jgOhYeah/Farm-PJON-LoRa-network/PumpMonitor/MemoryUsage.ods

Constants
EEPROM Size | 2048
Write endurance | 100000
Bytes per reading | Time between readings (m) | Total Readings Stored | Total stored time (d) | Life expectancy (years)
1 | 15 | 2048 | 21.3333333333333 | 5.70385580652521
2 | 30 | 1024 | 21.3333333333333 | 17.1115674195756
2 | 15 | 1024 | 10.6666666666667 | 8.55578370978782
1 | 30 | 2048 | 42.6666666666667 | 11.4077116130504
2 | 60 | 1024 | 42.6666666666667 | 34.2231348391513
 |  | #DIV/0! | #DIV/0! | 0
 |  | #DIV/0! | #DIV/0! | 0
 |  | #DIV/0! | #DIV/0! | 0
 |  | #DIV/0! | #DIV/0! | 0
 |  | #DIV/0! | #DIV/0! | 0
 |  | #DIV/0! | #DIV/0! | 0
 |  | #DIV/0! | #DIV/0! | 0
 |  | #DIV/0! | #DIV/0! | 0
 |  | #DIV/0! | #DIV/0! | 0
 |  | #DIV/0! | #DIV/0! | 0
 |  | #DIV/0! | #DIV/0! | 0
 |  | #DIV/0! | #DIV/0! | 0
 |  | #DIV/0! | #DIV/0! | 0
