jgOhYeah/Farm-PJON-LoRa-network/ElectricFenceMonitor/Simulations/Results.ods

Sheet: Sheet1
Lower resistor | 4700 | 10000 | 10000 | 10000 | 10000 | 10000 | 18000 | 15000 | 15000 | 15000
Supply voltage | 2.7 | 2.7 | 2.4 | 3.1 | 3 | 3 | 3 | 3 | 3 | 2.4
Lower bias R | 82000 | 82000 | 82000 | 82000 | 82000 | 100000 | 100000 | 100000 | 82000 | 82000
Upper bias R | 120000 | 120000 | 120000 | 120000 | 120000 | 100000 | 100000 | 100000 | 120000 | 120000
Fence | 4.7k lower divider, 2.7V supply | 10k lower divider, 2.7V supply | 10k lower divider, 2.4V supply | 10k lower divider, 3.1V supply | 10k lower divider, 3V supply | 10k lower divider, 3V supply | 18k lower divider, 3V supply | 15k lower divider, 3V supply | 15k lower divider, 3V supply | 15k lower divider, 2.4V supply | 0k lower divider, V supply | 0k lower divider, V supply | 0k lower divider, V supply | 0k lower divider, V supply | 0k lower divider, V supply
0 | 0.428702 | 0.428702 | 0.325486 | 0.57116 | 0.535142 | 0.788621 | 0.788621 | 0.788621 | 0.535142 | 0.325486
2000 | 0.429408 | 0.434631 | 0.330118 | 0.578843 | 0.54239 | 0.798976 | 0.825649 | 0.814729 | 0.554175 | 0.338308
4000 | 0.44867 | 0.58484 | 0.469106 | 0.741609 | 0.702229 | 0.97745 | 1.13881 | 1.08987 | 0.814147 | 0.582139
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
