jgOhYeah/Farm-PJON-LoRa-network/(threads)

Thread 3 (2021-07-01):

This project is beautiful!

gioblu, 2021-07-01:
Ciao @jgOhYeah compliments for the work done, this project is amazing, for sure a lot of people could benefit from it.
I am working on a new project called [BIPLAN](https://github.com/gioblu/BIPLAN) it is an experimental interpreted programming language designed to run on very limited microcontrollers, but include modern features and syntax. It will target both windows, linux and arduino compatible boards, in this moment the arduino support is broken because I am working on it, but you can test it on linux. I suspect it could be useful for you, if you can, let me know what you think about it. It is for now 10 times quicker than TinyBasicPlus and and around 2 times slower than python on linux.

Compliments again for the work done on Farm-PJON_LoRa-network and for publishing in the public domain.

jgOhYeah, 2021-07-02:
Hi @gioblu,
This isn't the best documented or neatest code, but it works :).
BIPLAN sounds interesting.  The main reason I used PICAXE chips with picaxe basic for the remote units was because I didn't have any other mcus with me at the time that would have a low enough power draw and be easily programmable in the field - all that is required to program them is a serial port of some description with a few other components. The picaxe system works well for what it does, but it does show its age at times.

I can see a few situations where I would consider using BIPLAN - for example, being able to have an interactive shell of some description or being able to run code from a non standard location such as an sd card or EEPROM. Would be useful for education as well or coordinating tasks.

I am not sure if I haven't found them yet, but if you are looking for things to add, a few things I would like (might not be possible or fit in with your idea of the language though):
- Command to write directly to registers and read from them. This would allow advanced / unusual features to be accessed if they are not implemented. For example, timers and adc registers.
- Interrupts. Probably architecture specific and anything using them would probably be time critical and need to be done in the c++ code.
- Time elapsed counter (`millis()`).
- Ability to call c++ functions from BIPLAN - so that time critical tasks can be started for example. I haven't ever used it, but apparently mmbasic can do something like this (although again, it is a version of basic).
- Object orientation (ok, probably not possible or fits in within the constraints, but I am starting to like it :) ).

Apart from that, it looks very well documented and structured, so good job. The c++ api looks good as well.

Incidentally, I have been working on a [tune playing](https://github.com/jgOhYeah/TunePlayer) library for Arduinos, which seems to have turned into an interpreter in its own right (although nowhere near as advanced as yours, very specialised and not Turing complete).

gioblu, 2021-07-02:
Thank you for your compliments:
- You have the way of accessing variables and strings as a single global array using:
```ruby
$foo = 1
print $foo # Prints 1
print index $foo # Prints 0 or the index of the first variable defined

print $[0] # Prints 1
$[0] = 0 # Sets $foo to 0
```
- I think Interrupt may not be a good idea because the interpreter is rather slow, probably more viable to call a c function.
- Yes, you have `millis`
- Yes calling a C/C++ function is in the TODO list
- Not sure about OOP

Thank you for the link and compliments for the work done on TunePlayer, I will have soon to implement mono sound, I will for sure check it out.

gioblu, 2021-07-02:
@jgOhYeah forgot to say I plan to support file system not only on linux (which works well already) but also on arduino, using sdcard + sdfat or equivalent.

gioblu, 2021-07-02:
Forgot to say, the target I have in mind for my personal use of BIPLAN is the Smart Response XE, being arduino compatible and having a decent amount of memory and ram.

https://hackaday.com/wp-content/uploads/2021/06/srxebasic_feat.jpg?w=600&h=450

that would be a cool addition to your setup, specially for monitoring and remote-control, although yes, the editor and the compiler could in there, and considering it has a nice qwerty keyboard and screen, you could even write, compile and run program in stand-alone mode.

jgOhYeah, 2021-07-03:
Hi @gioblu,
Good points with the comments on features. In terms of registers, I meant the likes of being able to read and write to the likes of `PORTD`, `TCCR1A` in the Amega328p, allowing finer control over timers and setting pins and directions all at once, although if there is support for calling C/C++ functions, then this is far less important. - In the PICAXE system, where everything has to be in BASIC and the interpreter cannot be updated or reprogrammed once the chip leaves the factory, the ability to write to hardware registers has saved the day a couple of times if something never got implemented or there was a mistake in how it was implemented. This does impact portability though.

My current base station for the farm is a raspberry pi running Thingsboard and a python script acting as a bridge, which while not necessarily the neatest, does most things I need it to.

If you are interested in sound libraries, I haven't tried it, but the [Noodle-Synth](https://github.com/nathanRamaNoodles/Noodle-Synth) library might also be worth a look at as it claims to support multiple notes at a time and directly interprets rttl ringtones without the need to compile tunes like TunePlayer. I only found it after I wrote TunePlayer :)
