jgOhYeah/Farm-PJON-LoRa-network/PumpMonitor/PumpMonitorVeroboardLayout/ExternalConnections.pdf

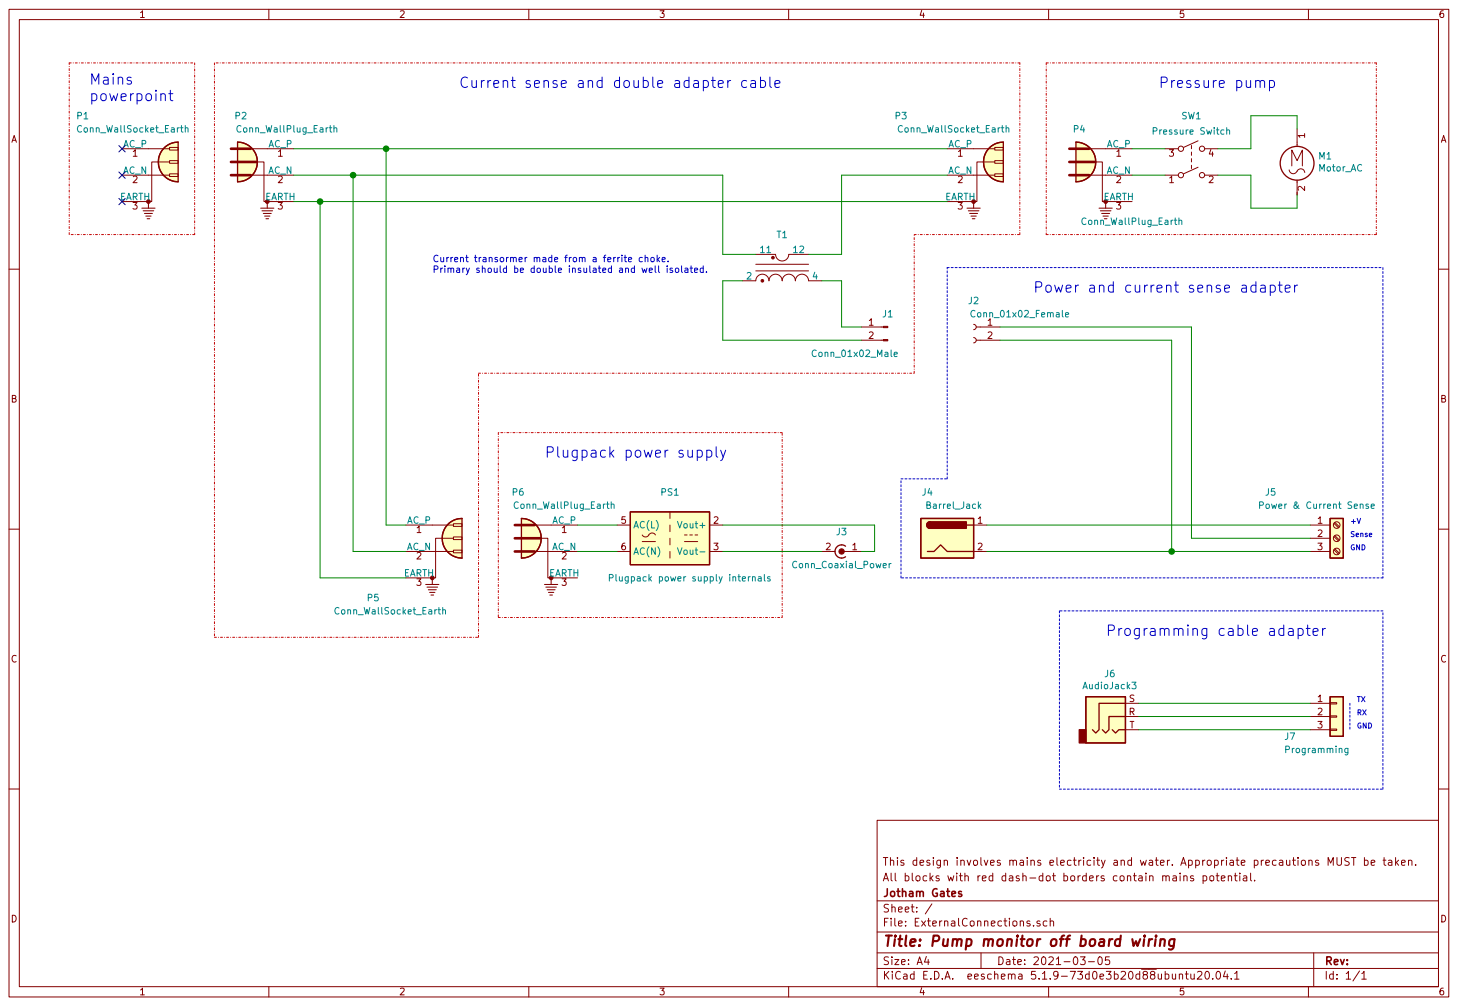
[picture p10: page 1]

TX Current sense and double adapter cable

Sense +V Plugpack power supply

This design involves mains electricity and water. Appropriate precautions MUST be taken.
File: ExternalConnections.sch Sheet: / Jotham Gates All blocks with red dash-dot borders contain mains potential.

Id: 1/1 Title: Pump monitor off board wiring
