jgOhYeah/Farm-PJON-LoRa-network/PumpMonitor/PumpMonitorVeroboardLayout/PumpMonitor.pdf

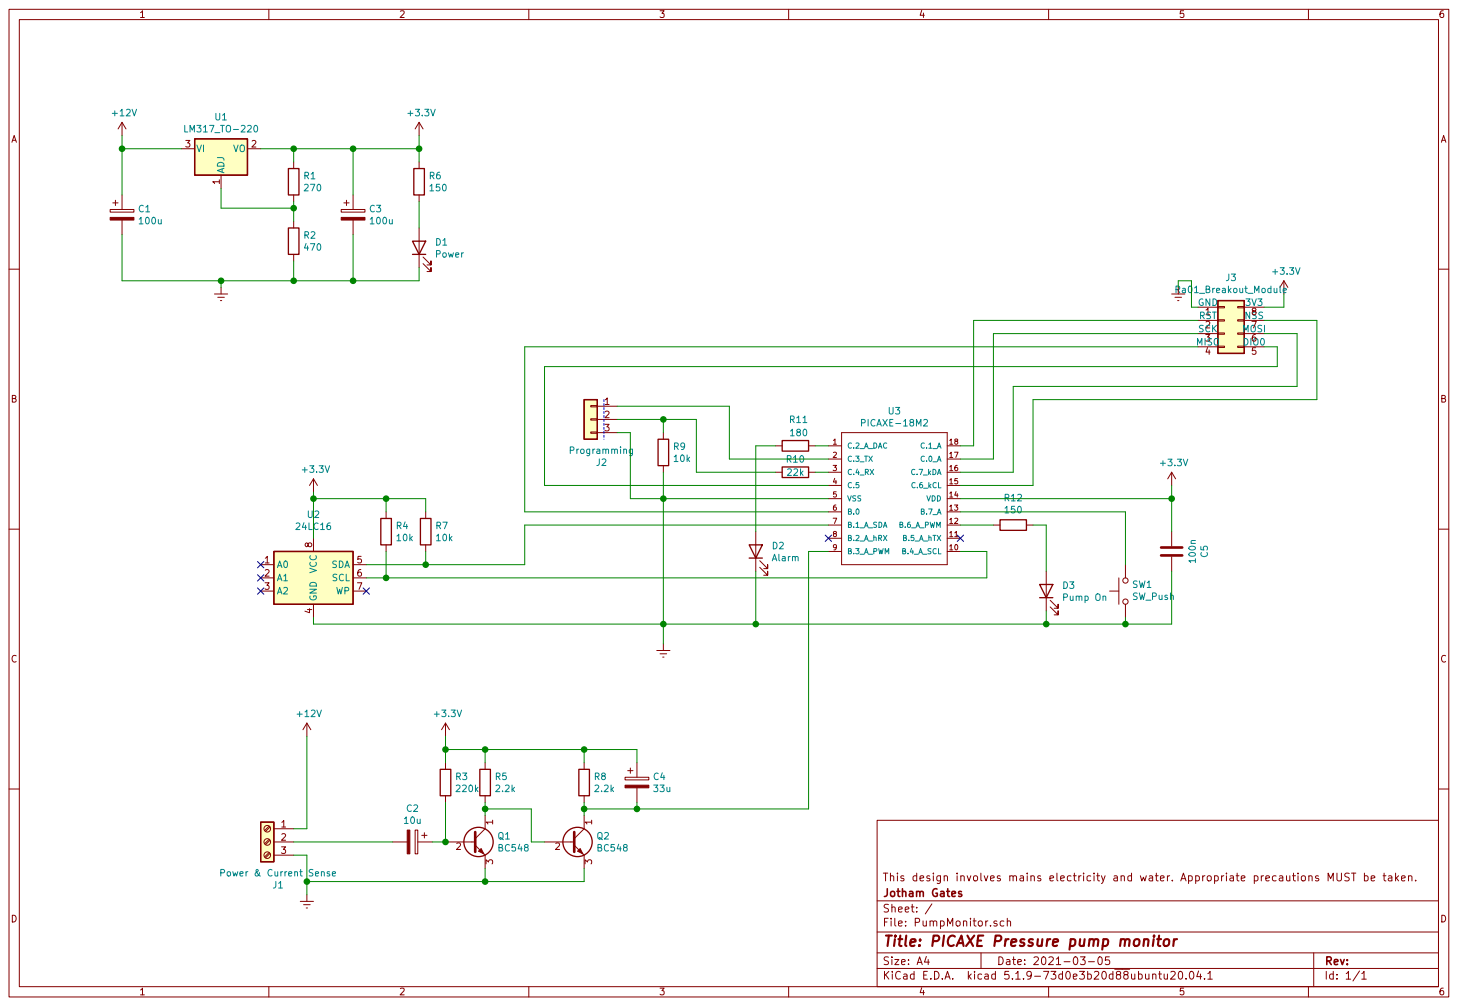
[picture p11: page 1]

4 SDA 5 SCL 6 WP 7 VCC

File: PumpMonitor.sch Sheet: / Jotham Gates This design involves mains electricity and water. Appropriate precautions MUST be taken.

Id: 1/1 Title: PICAXE Pressure pump monitor
