jgOhYeah/Farm-PJON-LoRa-network/ElectricFenceMonitor/ElectricFenceMonitor/drawing.pdf

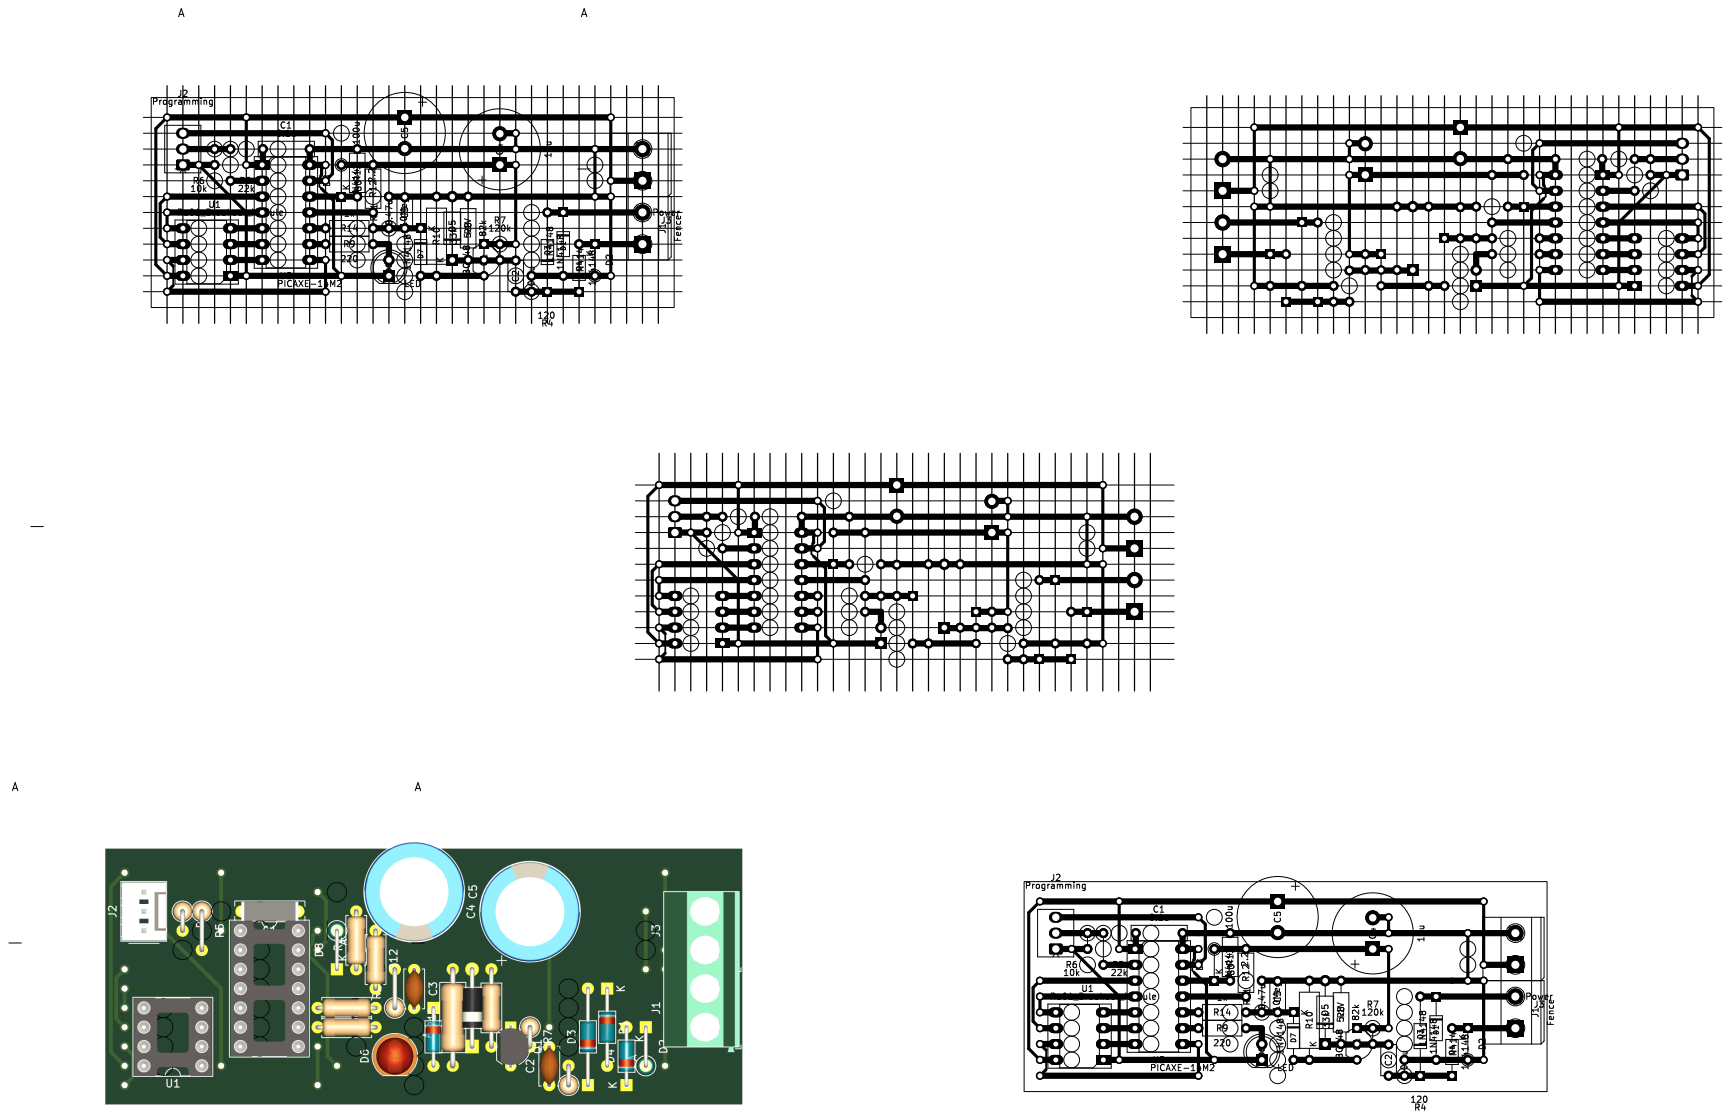
[picture p12: page 1]
