jgOhYeah/Farm-PJON-LoRa-network/ElectricFenceMonitor/Simulations/ElectricFenceMeterSimFullBridge.asc

B1: bv; V=idt(I(V2))
B2: bv; V=temp
B3: bv; V=V(vpeak)/V(varef)*1023
C1: cap; 0.22µ; V=6.3 Irms=2.52 Rser=0.0526265 Lser=0 mfg="KEMET" pn="C0805C224K9RAC" type="X7R"
C2: cap; 0.1µ
C3: cap; 10µ
C4: cap; 3n
D1: diode; 1N4148
D2: zener; UMZ5_1N
D3: diode; 1N4148
D4: diode; 1N4148
D5: diode; 1N4148
D6: diode; 1N4148
D7: diode; 1N4148
Q1: npn; BC547B
R1: res; 24.6Meg
R2: res; 15k
R3: res; 120k
R4: res; 82k
R5: res; 10Meg
R6: res; 33k
R7: res; 180
R8: res; 10k
V1: voltage; PWL value_scale_factor={VSCALE} 0.5 0 repeat forever (file=FencePulse.pwl) endrepeat
V2: voltage; 2.4
Named nets: 0, Vpeak, Vfence, Vdd, SupplyIntegrated, Gfence, Temperature, Varef, ADC
.tran 0 10 0
.step param VSCALE 0 1.5 0.2
.meas tran ave_cur FIND V(supplyintegrated) at 1.0
.meas tran max_output MAX V(Vpeak)
.param VSCALE=0.8
.meas tran max_fence MAX V(Vfence)
.step temp 0 70 20
.op
PULSE(0 2.4 0.1 0.001 0.001 10000)
.meas tran temperature FIND V(temperature) at 1.0
Temperature compensation and ADC
