jgOhYeah/Farm-PJON-LoRa-network/ElectricFenceMonitor/Simulations/ElectricFenceMeterFencePowered.asc

C1: cap; 100µ
D3: diode; 1N4148
D4: diode; 1N4148
D5: diode; 1N4148
D6: diode; 1N4148
R1: res; 1Meg
R2: res; 10Meg
V1: voltage; PWL value_scale_factor={VSCALE} 0.5 0 repeat forever (file=FencePulse.pwl) endrepeat
Named nets: Vfence, Gfence, 0
.tran 0 10 0
.step param VSCALE list 0.1 0.2 0.5 1 1.2
