jgOhYeah/Farm-PJON-LoRa-network/ElectricFenceMonitor/Simulations/ElectricFenceMeterSim.asc

B1: bv; V=idt(I(V2))
C1: cap; 2µ
C2: cap; 0.1µ
D1: diode; 1N4148
D2: zener; UMZ5_1N
Q1: npn; BC547B
R1: res; 20Meg
R2: res; 10k
R3: res; 100k
R4: res; 100k
R5: res; 10Meg
R6: res; 10k
V1: voltage; PWL value_scale_factor={VSCALE} 0.5 0 repeat forever (file=FencePulse.pwl) endrepeat
V2: voltage; 3.3
Named nets: 0, Vpeak, Vfence, Vdd, SupplyIntegrated
.tran 0 10 0
.step param VSCALE list 0.1 0.2 0.5 1 1.2
.meas tran ave_cur FIND V(supplyintegrated) at 1.0
