jgOhYeah/Farm-PJON-LoRa-network/PumpMonitor/CurrentSenseSimulation/20200124_amp_try_2.asc

C1: cap; 33µ
C2: cap; 10µ
D1: diode; 1N914
Q1: npn; BC547B
Q2: npn; BC547C
R1: res; 2.2k
R2: res; 220k
R3: res; 1e6
R4: res; 1k
R5: res; 2.2k
V1: voltage; SINE(0 0.01 50 0.4 0 0 40)
V2: voltage; 3.3; Rser=10
Named nets: 0
.tran 0 2 0 0.01
