jgOhYeah/Farm-PJON-LoRa-network/RasPiBaseStation/pjon.py

#!/usr/bin/python3
# from baseutils import *
# Clone PyLoRa for Python 3 from https://github.com/hnlichong/PyLora/tree/py35

class PJONPacketError(Exception):
    def __init__(self, message, packet = None):
        self.message = message
        self.packet = packet
class CRC:
    def crc32(self, data, length):
        bits = None
        crc = 0xFFFFFFFF
        current = 0
        while length > 0:
            length -= 1
            crc ^= data[current]
            current += 1
            bits = 8
            while bits > 0:
                bits -= 1
                if crc & 1:
                    crc = ((crc  & 0xFFFFFFFF) >> 1) ^0xEDB88320
                else:
                    crc = (crc & 0xFFFFFFFF) >> 1

        return (~crc) & 0xFFFFFFFF

    def crc8_roll(self, input_byte, crc):
        i = 8
        while i:
            result = (crc ^ input_byte) & 0x01
            crc >>= 1
            if result:
                crc ^= 0x97
            
            i-= 1
            input_byte >>= 1

        return crc

    def crc8(self, input_byte, length):
        crc = 0
        for b in range(length):
            crc = self.crc8_roll(input_byte[b], crc)

        return crc

class PJON:
    def __init__(self, id = 255, sender_id = True):
        self.id = id
        self.sender_id = sender_id

    def parse(self, packet): # TODO: FIX CHECKSUM INVALID
        """ Parses a bytearray packet into a tuple containing a list with the
        payload and the sender id. Raises a PJONPacketError if not a valid
        packet or addressed to us. """
        sender_id = None
        header = None
        length = None
        cumulative_length = 4
        is_crc32 = False
        payload = []
        crc = CRC()
        if len(packet) >= 4:
            if packet[0] == 0 or packet[0] == self.id:
                header = packet[1]
                length = packet[2]
                header_checksum = packet[3]
                calculated = crc.crc8(packet, 3)
                if header_checksum == calculated:
                    # Checksums match
                    if header & 0x02 and len(packet) >= 5: # TODO: Fix for if no sender id.
                        # Sender info is included and the packet is long enough
                        sender_id = packet[4]
                        cumulative_length += 1
                        crc_length = 1
                        if header & 0x020:
                            # CRC32 checksum
                            is_crc32 = True
                            crc_length = 4

                        # Get the payload
                        for i in range(cumulative_length, len(packet) - crc_length): # Using len() instead of length to stop truncated packets causing errors
                            payload.append(packet[i])

                        # Check the final crc
                        if is_crc32:
                            calclength = min(length, len(packet))
                            calculated = crc.crc32(packet, calclength - 4)
                            crc = (packet[calclength - 4] << 24) | (packet[calclength - 3] << 16) | (packet[calclength - 2] << 8) | packet[calclength - 1]

                        else:
                            calculated = crc.crc8(packet, length - 1)
                            crc = packet[length - 1]
                        if calculated != crc:
                            raise PJONPacketError("Failed end checksum", packet)
                        return (payload, sender_id)
                    else:
                        raise PJONPacketError("Too short for sender id", packet)
                else:
                    raise PJONPacketError("Failed header checksum", packet)
            else:
                raise PJONPacketError("Not to us", packet)
        else:
            raise PJONPacketError("Too short to be a packet", packet)
    
    def generate(self, to, payload, force_crc32 = False):
        """ Generates a bytes object with the processed packet. """
        # Calculate how long the packet would be if using crc8 or crc32 otherwise
        total_length = len(payload) + 5
        if self.sender_id:
            total_length += 1
        use_crc8 = True
        if force_crc32 or total_length > 15:
            use_crc8 = False
            total_length += 3 # for the 3 bytes crc32 is longer than crc8

        # Build the header
        header = 0 # 0b00100110 # CRC32, ACK, TX info
        if self.sender_id:
            header |= 0b00000010
        if not use_crc8:
            header |= 0b00100000
        
        # Add the header crc8
        crc = CRC()
        packet = [to, header, total_length]
        packet.append(crc.crc8(packet, len(packet)))

        # Add the sender id if requested
        if self.sender_id:
            packet.append(self.id)
        
        # Add the payload
        for i in payload:
            packet.append(i)
        
        # Add the crc at the end
        if use_crc8:
            packet.append(crc.crc8(packet, len(packet)))
        else:
            crc32 = crc.crc32(packet, len(packet))
            packet.append((crc32 >> 24) & 0xFF)
            packet.append((crc32 >> 16) & 0xFF)
            packet.append((crc32 >> 8) & 0xFF)
            packet.append(crc32 & 0xFF)
        
        # Done
        return bytes(packet)


if __name__ == "__main__":
    pjon = PJON()
    data = bytearray(b'\xff&\x10_JV\x80\x00F\x01r\x01\x9a\xfb\xad\x95')
    print(list(data))
    print(pjon.parse(data))
