jgOhYeah/Farm-PJON-LoRa-network/RasPiBaseStation/ExampleData.py

data = [
bytearray(b'\x00\x00\x00\x00\x00'),
bytearray(b'\xff\x16:Wos\x02\x00C\xbd\x01\x02\xd1hS'),
bytearray(b'\xff\xe6_R\x93\\\x9f\x03h\xc0\x01\xb0af\xf8'),
bytearray(b'\xff&\x0f\x07ZP_\x00a\xae\x01\xd9}q\xeb'),
bytearray(b'\xff&\x0f\x07ZP:\x00a\xb2\x01n\xd8\xd4\x8b'),
bytearray(b'\xff&\x0f\x07ZP\x00\x00a\xa2\x01\xcf\x8bf\xfd'),
bytearray(b'\xff&\x0f\x07ZP\x00\x00a\xa3\x01\xd6\x90W\xbc'),
bytearray(b'\xff&\x0f\x07ZP\x00\x00a\xa4\x01\x99\xd1\xc1{'),
bytearray(b'\xff&\x0f\x07ZP\x00\x00a\xa5\x01\x80\xca\xf0:'),
bytearray(b'\xff&\x0f\x07ZP\x00\x00a\xa6\x01\xab\xe7\xa3\xf9'),
bytearray(b'\xff&\x0f\x07ZP\x00\x00a\xa7\x01\xb2\xfc\x92\xb8'),
bytearray(b'\xff&\x0f\x07ZP\x00\x00a\xa8\x015d\x8ew'),
bytearray(b'\xff&\x0f\x07ZP\x00\x00a\xa9\x01'),
bytearray(b'\xff&\x0f\x07ZP\x00\x00a\xaa\x01\x07R\xec\xf5'),
bytearray(b'\xff&\x0f\x07ZP\x00\x00a\xab\x01\x1eI\xdd\xb4'),
bytearray(b'\xff&\x0f\x07ZP\x00\x00a\xac\x01Q\x08Ks'),
bytearray(b'\xff&\x0f\x07ZP\x00\x00a\xad\x01H\x13z2'),
bytearray(b'\xff&\x0f\x07ZP\x00\x00a\xaf\x01z%\x18\xb0'),
bytearray(b'\xff&\x0f\x07ZP\x00\x00a\xb5\x01\xca\x08\xe2k'),
bytearray(b'\xff&\x0f\x07ZP\x00\x00a\xb6\x01\xe1%\xb1\xa8'),
bytearray(b'\xff&\x0f\x07ZP\x00\x00a\xbc\x01\x1b\xcaY"'),
bytearray(b'\xff&\x0f\x07ZP\x00\x00a\xbf\x010\xe7\n\xe1'),
bytearray(b'\xff&\x0f\x07ZP\x00\x00a\xc5\x01\xe57\x9b\x9d'),
bytearray(b'\xff&\x0f\x07ZP\x0e\x01a\xb1\x01\xa9\xe8\xfek'),
bytearray(b'\xff&\x0f\x07ZP\x10\x15a\xbe\x01)\xfc;\xa0'),
bytearray(b'\xff&\x0f\x07ZP\x8a\x01a\xae\x01 \xd4\xe6\xa7'),
bytearray(b'\xff&\x0f\x07ZP\x9e\x04a\xa3\x017\xc4Y\x9a'),
bytearray(b'\xff&\x0f\x07ZP\xaf\x00a\xb4\x01!d\xdbm'),
bytearray(b'\xff&\x0f\x07Zp\xbb \xeb\x90\x05_N\x88\xb9'),
bytearray(b'\xff&\x0f\x07ZP\xf5\ra\xa7\x01\xc0B\x95H'),
bytearray(b'\xff&\x0f\x07ZP\xfd\x00a\xa5\x010nd\xd6'),
bytearray(b'\xff&\x0f\x07ZP2\x00a\xa8\x01\xee\x85e\x91'),
bytearray(b'\xff&\x0f\x07ZP4\x00a\xa3\x01\x821I\xfa'),
bytearray(b'\xff&\x0f\x07ZP4\x00a\xa8\x01a\xc5\x901'),
bytearray(b'\xff&\x0f\x07ZP5\x00a\xaa\x01n\x93\xdb\x03'),
bytearray(b'\xff&\x0f\x07ZP5\x00a\xb8\x01\x16g\xab\xd0'),
bytearray(b'\xff&\x0f\x07ZP6\x00a\xb9\x01H\xdc\xe0A'),
bytearray(b'\xff&\x0f\x07ZP7\x00a\xaf\x01i$|&'),
bytearray(b'\xff&\x0f\x07ZP7\x00a\xb3\x01\x8fS!{'),
bytearray(b'\xff&\x0f\x07ZP7\x00a\xb5\x01\xd9\t\x86\xfd'),
bytearray(b'\xff&\x0f\x07ZP8\x00a\xae\x01\xf2o\xda\xb6'),
bytearray(b'\xff&\x0f\x07ZP8\x00a\xb4\x01BB m'),
bytearray(b'\xff&\x0f\x07ZPc\x08a\xa9\x017Y\x9aD'),
bytearray(b'\xff&\x0f\x07ZPm\x00a\xa5\x01\xe1hC\xc6'),
bytearray(b'\xff&\x0f\x07ZPW\x01a\xb5\x01\xf8\x87\x96\xd5'),
bytearray(b'\xff&\x10_JV}\x00F\x01r\x013\xf7\xa7R'),
bytearray(b'\xff&\x10_JV\x7f\x00F\x01r\x01~?\x06Y'),
bytearray(b'\xff&\x10_JV\x80\x00F\x01r\x01\x9a\xfb\xad\x95'),
bytearray(b'\xff&\x10_JV\x81\x00F\x01r\x01Q\xa7~0'),
bytearray(b'\xff&\x10_JV\x82\x00F\x01r\x01\xd73\x0c\x9e'),
bytearray(b'\xff&\x10_JV\x83\x00F\x01r\x01\x1co\xdf;'),
bytearray(b'\xff&\x10_JV\x84\x00F\x01B\x01\x01j\xef\x83'),
bytearray(b'\xff&\x10_JV\x84\x00F\x01r\x01\x01j\xef\x83'),
bytearray(b'\xff&\x10_JV\x85\x00F\x01r\x01\xca6<&'),
bytearray(b'\xff&\x10_JV\x86\x00F\x00r\x01M`$\xbf'),
bytearray(b'\xff&\x10_JV\x86\x00F\x01r\x01L\xa2N\x88'),
bytearray(b'\xff&\x10_JV+\x00F\x01r\x01\xb5c\xd5\xfc'),
bytearray(b'\xff&\x10_JV~\x00F\x01r\x01\xb5c\xd5\xfc'),
bytearray(b'\xff&\x10_JVx\x00F\x01r\x01c:6\xe1'),
bytearray(b'\xff&\x10_JVy\x06F7r\x01~?\x06Y'),
bytearray(b'\xff&\x10UJV~\x00F\x01r\x01\xb5c\xd5\xfc'),
bytearray(b'\xff&\xd5UJV}\x00N\x01ra3\xf7\xa7R'),
bytearray(b'\xff>?\x9aC\x19G\x04-\xbf\x02\xf7\xfb\xff\xe5'),
bytearray(b'\xffF\x0f\x0bZd:\x8ak\x1a\x085\x88W\xb3'),
bytearray(b'J\x06\x07\xff\xff\xf3~'),
bytearray(b'J\x06\x08\x90\xff\xc6\x00\xc6'),
bytearray(b'J\x06\x08\x90\xff\xc6\x01@'),
bytearray(b"\xff&\x0f\x07ZP\x00\x00a\xb1\x01\xaed\'o")
]
