jgOhYeah/Farm-PJON-LoRa-network/(commit log)

2021-01-27 Add battery volts monitor, base station and readme
    [BatteryMonitorVeroboardLayout.kicad_pcb, BatteryMonitorVeroboardLayout.sch]
2021-03-01 Added PumpMonitor Files
    [20210114_1510.ods, MemoryUsage.ods]
2021-03-13 Added pump monitor
    [ExternalConnections.sch, PumpMonitor.kicad_pcb, PumpMonitor.sch]
2021-03-21 Started splitting into slots, slot 0 should work.
2021-03-21 Theoretically works, updated schematic
2021-04-04 Got interrupts working
2021-04-05 Tidied and version running on pump currently
    [MemoryUsage.ods, RecordedData.ods]
2021-04-05 Copied Raspi Files across
    [records.csv]
2021-06-29 Added interval support to Arduino
2021-07-02 Got RPC Working and updated
    [records.csv]
2021-12-02 Added prototype water baby
2021-12-03 As running on pump
2023-02-21 Cleaning up and adding resetting + temperature consisency detection
    [ExternalConnections.kicad_sch, ExternalConnections.sch, PumpMonitor.kicad_pcb, PumpMonitor.kicad_sch, PumpMonitor.sch]
2023-02-22 Updating pump monitor to use common lora pjon file
2023-02-22 Started moving battery volts to multiple slots
2023-05-31 Hopefully fixed two's complement for - temps. On fence
    [BatteryVoltsMonitor_slot1.bas, compiled_slot0.bas, compiled_slot1.bas]
2023-06-20 Attempt at fixing add_word - divded by 255 instead of 256
    [BatteryVoltsMonitor_slot1.bas, compiled_slot0.bas, compiled_slot1.bas]
2024-01-27 Updated kicad version
    [PumpMonitor.kicad_pcb, PumpMonitor.kicad_sch]
2024-01-27 Started adding temperature and humidity.
2024-01-27 Added temperature sensor CRC check
    [PumpMonitor.kicad_pcb, PumpMonitor.kicad_sch]
2024-04-03 Corrected add_word in pump monitor (same issue as corrected for fence)
    [PumpMonitor_slot1.bas, compiled_slot0.bas, compiled_slot1.bas]
2024-11-09 Updated battery and pump monitor KiCAD files to be openable
    [BatteryMonitorVeroboardLayout.kicad_pcb, BatteryMonitorVeroboardLayout.kicad_sch, BatteryMonitorVeroboardLayout.sch, ElectricFenceMonitor.kicad_pcb, ElectricFenceMonitor.kicad_sch, PumpMonitor.kicad_sch]
2024-11-09 Electric fence layout planned
    [ElectricFenceMonitor.kicad_pcb, ElectricFenceMonitor.kicad_sch]
2024-11-10 Added board layout for water baby
    [WaterbabyLayout.kicad_pcb, WaterbabyLayout.kicad_sch]
2024-11-10 Waterbaby pinout updated, power saving implemented
2024-11-11 Reduced LED flash time to save power
2024-12-16 Water baby layout, electric fence simulations
    [ElectricFenceMonitor.kicad_pcb, ElectricFenceMonitor.kicad_sch, Results.ods]
2024-12-17 Added IR ADC sampler
2024-12-18 Added letter to transmitter serial, ADC simulations
2024-12-19 Electric fence monitor schematic updated, layout redone
    [ElectricFenceMonitor.kicad_pcb, ElectricFenceMonitor.kicad_sch]
2024-12-21 Started gate monitor, fence monitor code adapted mostly
    [GateMonitorLayout.kicad_pcb, GateMonitorLayout.kicad_sch, WaterbabyLayout.kicad_sch]
2024-12-22 Gate monitor layout mostly done
    [GateMonitorLayout.kicad_pcb, GateMonitorLayout.kicad_sch]
2024-12-26 Added holes and grid to gate monitor layout
    [GateMonitorLayout.kicad_pcb, GateMonitorLayout.kicad_sch]
2024-12-29 Fence monitor uses internal temp and more accurate battery voltage monitoring
2024-12-31 Removed unnecessary acknowledge from PJON headers for pump, fence, fence monitor, water baby
2025-01-01 Acknowledge updated on fence, fence battery voltage is now rounded correctly
    [BatteryVoltsMonitor_slot1.bas, compiled_slot0.bas, compiled_slot1.bas]
2025-01-03 Sppeding up spi, acknowledgement works
